hitwow/CPU-VHDL/CPU设计报告.docx

计算机设计与实践

CPU设计报告

班号：110103

学号：1110310305

姓名：王天博

## 1． 指令格式设计

指令伪码 | 指 令 | | | | 寻址方式
mov ri, n | 00000 | Ri | N | | 立即寻址
mov [addr], ri | 00001 | Ri | ADDR | | 直接寻址（寄存器->主存）
mov ri, [addr] | 00010 | Ri | ADDR | | 直接寻址（主存->寄存器）
mov ri, rj | 01000 | Ri | | Rj | 寄存器寻址
mov ri, [addr] | 00011 | Ri | ADDR | | 变址寻址
mov ri, @rj | 11000 | Ri | | Rj | 寄存器间址
adc ri, rj | 01001 | Ri | | Rj | 寄存器寻址
adc ri, n | 00100 | Ri | N | | 立即寻址
sbb ri, rj | 01010 | Ri | | Rj | 寄存器寻址
sbb ri, n | 00101 | Ri | N | | 立即寻址
and ri, rj | 01011 | Ri | | Rj | 寄存器寻址
and ri, n | 00110 | Ri | N | | 立即寻址
or ri, rj | 01100 | Ri | | Rj | 寄存器寻址
or ri, n | 00111 | Ri | N | | 立即寻址
stc | 10111 | | | | 无
clc | 11111 | | | | 无
jmp [addr] | 10000 | | ADDR | | 直接寻址
jz sign | 10001 | | SIGN | | 相对寻址
jc sign | 10010 | | SIGN | | 相对寻址

说明：

1. N为8位立即数
2. ADDR为地址低八位
3. Ri，Rj为寄存器编号，3位
4. SIGN为8位有符号数

## 2． 微操作的定义

微操作 | 含义
M(AD)->IR | 将存储器AD地址中的数据读到IR中
TD->M(TA) | 将TD中的数据写入存储器的TA地址中
1->RD | 将RD读信号置位
1->WR | 将WR写信号置位
1->RUD | 将RUD寄存器更新信号置位
1->PUD | 将PUD PC更新信号置位
0->Cy | 将Cy标志位清零
1->Cy | 将Cy标志位置位
OP(IR) | 取IR的15-11位的操作码
NM(IR) | 取IR的7-0位的操作数
Ad1(IR) | 取IR的10-8位的第一个寄存器编号
Ad2(IR) | 取IR的2-0位的第二个寄存器编号
Ad(IR) | 取IR的7-0位作为地址低八位
Reg(RN) | 编号为RN的寄存器
A+B+Cy | 寄存器A中的值与寄存器B中的值进行带进位加运算
A-B-Cy | 寄存器A中的值与寄存器B中的值进行带借位减运算
A and B | 寄存器A中的值与寄存器B中的值进行按位与运算
A or B | 寄存器A中的值与寄存器B中的值进行按位或运算
R7//Ad(IR) | R7作为地址的高八位，AD(IR)作为地址的低八位，拼接成16位物理地址
Z·Aluout->PDATA | 如果Z标志位为0，则将aluout的值送至PDATA
Cy·Aluout->PDATA | 如果Cy标志位为0，则将aluout的值送至PDATA

## 3． 节拍的划分

### 3.1. 非访存类指令

mov Ri, x

T0 M(PC)->IR, 1->RD, PC->PC+1

T1 OP(IR)->C, NM(IR)->RDATA

T2

T3 Ad1(IR)->RN, 1->RUD, RDATA->Reg(RN)

mov Rj, Ri

T0 M(PC)->IR, 1->RD, PC->PC+1

T1 OP(IR)->C, Reg(Ad2(IR))->RDATA

T2

T3 Ad1(IR)->RN, 1->RUD, RDATA->Reg(RN)

adc Ri, x

T0 M(PC)->IR, 1->RD, PC->PC+1

T1 OP(IR)->C, Reg(Ad1(IR))->A, NM(IR)->B, A+B+Cy->Aluout

T2

T3 Ad1(IR)->RN, Aluout->RDATA, 1->RUD, RDATA->Reg(RN)

adc Rj, Ri

T0 M(PC)->IR, 1->RD, PC->PC+1

T1 OP(IR)->C, Reg(Ad1(IR))->A, Reg(Ad2(IR))->B, A+B+Cy->Aluout

T2

T3 Ad1(IR)->RN, Aluout->RDATA, 1->RUD, RDATA->Reg(RN)

sbb Ri, x

T0 M(PC)->IR, 1->RD, PC->PC+1

T1 OP(IR)->C, Reg(Ad1(IR))->A, NM(IR)->B, A-B-Cy->Aluout

T2

T3 Ad1(IR)->RN, Aluout->RDATA, 1->RUD, RDATA->Reg(RN)

sbb Rj, Ri

T0 M(PC)->IR, 1->RD, PC->PC+1

T1 OP(IR)->C, Reg(Ad1(IR))->A, Reg(Ad2(IR))->B, A-B-Cy->Aluout

T2

T3 Ad1(IR)->RN, Aluout->RDATA, 1->RUD, RDATA->Reg(RN)

and Ri, x

T0 M(PC)->IR, 1->RD, PC->PC+1

T1 OP(IR)->C, Reg(Ad1(IR))->A, NM(IR)->B, A and B->Aluout

T2

T3 Ad1(IR)->RN, Aluout->RDATA, 1->RUD, RDATA->Reg(RN)

and Rj, Ri

T0 M(PC)->IR, 1->RD, PC->PC+1

T1 OP(IR)->C, Reg(Ad1(IR))->A, Reg(Ad2(IR))->B, A and B->Aluout

T2

T3 Ad1(IR)->RN, Aluout->RDATA, 1->RUD, RDATA->Reg(RN)

or Ri, x

T0 M(PC)->IR, 1->RD, PC->PC+1

T1 OP(IR)->C, Reg(Ad1(IR))->A, NM(IR)->B, A or B->Aluout

T2

T3 Ad1(IR)->RN, Aluout->RDATA, 1->RUD, RDATA->Reg(RN)

or Rj, Ri

T0 M(PC)->IR, 1->RD, PC->PC+1

T1 OP(IR)->C, Reg(Ad1(IR))->A, Reg(Ad2(IR))->B, A or B->Aluout

T2

T3 Ad1(IR)->RN, Aluout->RDATA, 1->RUD, RDATA->Reg(RN)

clc

T0 M(PC)->IR, 1->RD, PC->PC+1

T1 OP(IR)->C, 0->Cy

T2

T3

stc

T0 M(PC)->IR, 1->RD, PC->PC+1

T1 OP(IR)->C, 1->Cy

T2

T3

### 3.2. 访存类指令

mov addr, Ri

T0 M(PC)->IR, 1->RD, PC->PC+1

T1 OP(IR)->C, R7//Ad(IR)->TA, Reg(Ri)->TD

T2 TD->M(TA), 1->WR

T3

mov Ri, addr

T0 M(PC)->IR, 1->RD, PC->PC+1

T1 OP(IR)->C, R7//Ad(IR)->TA

T2 Aluout->TA, M(TA)->TD, 1->RD

T3 TD->RDATA, Ad1(IR)->RN, 1->RUD, RDATA->Reg(RN)

mov Ri, x (变址寻址，IX=R7）

T0 M(PC)->IR, 1->RD, PC->PC+1

T1 OP(IR)->C, R7+x->TA

T2 M(TA)->TD, 1->RD

T3 TD->RDATA, Ad1(IR)->RN, 1->RUD, RDATA->Reg(RN)

mov Ri, Rj (寄存器间址)

T0 M(PC)->IR, 1->RD, PC->PC+1

T1 OP(IR)->C, R7//Rj->TA

T2 M(TA)->TD, 1->RD

T3 TD->RDATA, Ad1(IR)->RN, 1->RUD, RDATA->Reg(RN)

### 3.3. 转跳指令

jmp addr

T0 M(PC)->IR, 1->RD, PC->PC+1

T1 OP(IR)->C, R7//Ad(IR)->PDATA

T2

T3 PDATA->PC, 1->PUD

jz sign

T0 M(PC)->IR, 1->RD, PC->PC+1

T1 OP(IR)->C, SN(IR)->A, A+PC->Aluout, Z·Aluout->PDATA

T2

T3 PDATA->PC, 1->PUD

jc sign

T0 M(PC)->IR, 1->RD, PC->PC+1

T1 OP(IR)->C, SN(IR)->A, A+PC->Aluout, Cy·Aluout->PDATA

T2

T3 PDATA->PC, 1->PUD

## 4． 处理器结构框图和功能描述

### 4.1. 整体设计框图

注：1. 图中连线名称为例化时相应的信号名

2. 由于图中空间有限，因而2根以上线的根数没有在图中标出，现单独列出如下：

连线名 | 连线根数
pc_o | 16
pc_i | 16
ir_i | 16
ir_o | 16
ad_o | 16
ad_i | 16
aluout | 8
r_n | 3
r_i | 8
r_o | 8
dt_i | 8
dt_o | 8
a_bus | 16
DBUS | 16

### 4.2. 处理器功能描述

处理器共分为六个模块。由机器周期的定义，将系统划分为四个主要模块：取指模块掌管取指周期，运算模块掌管运算周期，存储模块掌管访存周期，回写模块掌管回写周期。四个模块的工作流程由时钟模块统一调度。同时，在主存储器和各管理模块之间增加访存控制模块，来避免发生访问冲突以及保证空闲时总线不被占用。

在处理器开始工作时：

第一个节拍，取指模块将当前pc值发送给访存控制模块，由访存控制模块根据pc值读出存储器中的数据回传给取指模块，作为当前的ir指令，取指模块将ir指令发送给各模块；之后在第二个节拍的下降沿进行pc+1

第二个节拍，运算模块将传来的ir指令进行译码，根据操作码进行不同的运算。非访存类指令，运算的结果通过aluout输出给回写模块进行回写；访存类指令，将算出的地址通过ad_o输出给存储模块，若有要写入的数据则通过aluout输出到存储模块；转跳类指令，计算出新的pc值，然后将新的pc值通过ad_o输出给回写模块；

第三个节拍，如果有访存活动，则存储模块根据操作码的不同，或读或写，向访存控制模块发送读写信号，地址和数据，并将读出的数据通过Reg_o送到回写模块；

第四个节拍，如果有转跳指令，判断转跳的条件，若成立则发送pc更新信号和新的pc值给取指模块；若有回写寄存器的要求，则将回写的数值和回写的寄存器标号送到运算模块并发送回写信号。

## 5． 各功能模块结构框图和功能描述

### 5.1. 时钟模块

#### 5.1.1. 结构框图

clk

reset

c1

c2

c3

c4

时钟模块

#### 5.1.2. 信号定义

信号名 | 位数 | 方向 | 含义
clk | 1 | I | 时钟信号
reset | 1 | I | 复位信号
c1 | 1 | O | 节拍1
c2 | 1 | O | 节拍2
c3 | 1 | O | 节拍3
c4 | 1 | O | 节拍4

#### 5.1.3. 功能描述

向其他模块发送节拍信号，控制整个运行流程。

### 5.2. 取指模块

#### 5.2.1. 结构框图

c1

c2

reset

PC_O

IR_O

IR_R

PC_C

PC_I

取指模块

#### 5.2.2. 信号定义

信号名 | 位数 | 方向 | 含义
c1 | 1 | I | 节拍1，控制取值
c2 | 1 | I | 节拍2，控制PC+1
reset | 1 | I | 复位信号
IR_I | 16 | I | 访存控制模块传入的IR
PC_C | 1 | I | 回写模块传来的PC更新信号
PC_I | 16 | I | 回写模块传来的PC的更新值
PC_O | 16 | O | 向其他模块输出的PC值
IR_O | 16 | O | 向其他模块输出的IR值
IR_R | 1 | O | 向访存控制模块发送的读IR信号

#### 5.2.3. 功能描述

1. 向访存控制模块发送PC的内容，并接受访存控制模块传来的IR值；

2. 向各个模块发送IR的值

3. 若回写模块没有更新信号则将PC+1，若有则接收回写模块的信号更新PC

### 5.3. 运算模块

#### 5.3.1. 结构框图

c2

reset

IR_O

PC_O

Reg_C

Reg_I

Reg_N

AD_O

aluout

Z

Cy

运算模块

#### 5.3.2. 信号定义

信号名 | 位数 | 方向 | 含义
c2 | 1 | I | 节拍2，控制运算模块的执行
reset | 1 | I | 复位信号
IR_O | 16 | I | 取指模块传来的IR
PC_O | 16 | I | 取指模块传来的PC
Reg_C | 1 | I | 回写模块传来的寄存器更新信号
Reg_N | 3 | I | 回写模块传来的寄存器更新编号
Reg_I | 8 | I | 回写模块传来的寄存器更新数值
AD_O | 16 | O | 输出算出的地址
aluout | 8 | O | 输出算出的数据
Z | 1 | O | 零标志新号
Cy | 1 | O | 进位标志信号

#### 5.3.3. 功能描述

1. 根据IR操作码部分执行不同的运算

2. 接收回写模块传入的寄存器数据进行寄存器回写

### 5.4. 存储模块

#### 5.4.1. 结构框图

c3

reset

aluout

AD_O

IR_O

DT_O

Reg_O

AD_I

DT_I

WR_O

RD_O

存储模块

#### 5.4.2. 信号定义

信号名 | 位数 | 方向 | 含义
c3 | 1 | I | 节拍3，控制存储模块的执行
reset | 1 | I | 复位信号
IR_O | 16 | I | 取指模块传来的IR
AD_O | 16 | I | 运算模块传来的地址
aluout | 8 | I | 运算模块传来的数据
DT_I | 8 | I | 访存控制模块传来的数据
DT_O | 8 | O | 给访存控制模块送要写入的数据
RD_O | 1 | O | 给访存控制模块的读信号
WR_O | 1 | O | 给访存控制模块的写信号
Reg_O | 8 | O | 给回写模块送的数据
AD_I | 16 | O | 给访存控制模块送的地址

#### 5.4.3. 功能描述

1. 将要写入存储器的数据发送到访存控制模块，并向访存控制模块发送写入信号

2. 接收访存控制模块传来的数据送到回写模块

### 5.5. 回写模块

#### 5.5.1. 结构框图

reset

c4

aluout

AD_O

IR_O

Reg_O

Z

Cy

Reg_I

Reg_N

PC_I

Reg_C

PC_C

回写模块

#### 5.5.2. 信号定义

信号名 | 位数 | 方向 | 含义
c4 | 1 | I | 节拍4，控制回写模块的执行
reset | 1 | I | 复位信号
IR_O | 16 | I | 取指模块传来的IR
AD_O | 16 | I | 运算模块传来的地址
aluout | 8 | I | 运算模块传来的数据
Reg_O | 8 | I | 存储模块传来的数据
Z | 1 | I | 零标志信号
Cy | 1 | I | 进位标志信号
Reg_N | 3 | O | 寄存器更新编号
Reg_C | 1 | O | 寄存器更新信号
Reg_I | 8 | O | 寄存器更新数值
PC_C | 1 | O | PC更新信号
PC_I | 16 | O | PC更新数值

#### 5.5.3. 功能描述

1. 若转跳指令生效，则将转跳的地址写入PC；

2. 若有写入寄存器的操作，则发送寄存器回写信号，回写寄存器的值还有回写的寄存器编号

### 5.6. 访存控制模块

#### 5.5.1. 结构框图

RD_O

WR_O

PC_O

IR_R

AD_O

DT_O

DT_I

IR_I

nRD

nWR

ABUS

DBUS

nMREQ

nBLE

nBHE

访存控制模块

#### 5.5.2. 信号定义

信号名 | 位数 | 方向 | 含义
RD_O | 1 | I | 存储模块发来的读信号
WR_O | 1 | I | 存储模块发来的写信号
PC_O | 16 | I | 取指模块发来的PC值
IR_R | 1 | I | 取指模块发来的IR读信号
AD_O | 16 | I | 存储模块发来的地址
DT_O | 8 | I | 存储模块发来的写数据
DT_I | 8 | O | 向存储模块送出的读出数据
nRD | 1 | O | 存储器读控制
nWR | 1 | O | 存储器写控制
ABUS | 16 | O | 地址总线
DBUS | 16 | I/O | 数据总线
IR_I | 16 | O | 向取指模块发送的IR值
nBHE | 1 | O | 存储器高位字节允许访问
nBLE | 1 | O | 存储器低位字节允许访问
nMREQ | 1 | O | 存储器片选

#### 5.5.3. 功能描述

1. 向存储器中取指令或数据

2. 向存储器中写入数据

## 6． 实验代码和测试序列

### 6.1. VHDL代码

#### 时钟模块-clkblock.vhd

library IEEE;

use IEEE.STD_LOGIC_1164.ALL;

use IEEE.STD_LOGIC_ARITH.ALL;

use IEEE.STD_LOGIC_UNSIGNED.ALL;

entity clkblock is

port(clk : in std_logic;

reset : in std_logic;

c1 : out std_logic;

c2 : out std_logic;

c3 : out std_logic;

c4 : out std_logic);

end clkblock;

architecture Behavioral of clkblock is

signal t : std_logic_vector(3 downto 0);

begin

process (reset, clk)

begin

if reset = '1' then

t <= "0000";

else

if clk'event and clk='1' then

case t is

when "0000" => t <= "0001";

when "0001" => t <= "0010";

when "0010" => t <= "0100";

when "0100" => t <= "1000";

when "1000" => t <= "0001";

when others => t <= "0000";

end case;

end if;

end if;

end process;

c1 <= t(0);

c2 <= t(1);

c3 <= t(2);

c4 <= t(3);

end Behavioral;

#### 取指模块-ifblock.vhd

library IEEE;

use IEEE.STD_LOGIC_1164.ALL;

use IEEE.STD_LOGIC_ARITH.ALL;

use IEEE.STD_LOGIC_UNSIGNED.ALL;

entity ifblock is

Port ( c1 : in STD_LOGIC;

c2 : in STD_LOGIC;

PC_O : out STD_LOGIC_VECTOR (15 downto 0);

IR_I : in STD_LOGIC_VECTOR (15 downto 0);

IR_O : out STD_LOGIC_VECTOR (15 downto 0);

PC_C : in STD_LOGIC;

PC_I : in STD_LOGIC_VECTOR (15 downto 0);

IR_R : out STD_LOGIC;

reset : in STD_LOGIC);

end ifblock;

architecture Behavioral of ifblock is

signal PC_T : std_logic_vector (15 downto 0);

begin

process (reset, c1, c2, PC_C, IR_I)

begin

if reset='1' then

PC_T <= "0000000000000000";

IR_O <= "0000000000000000";

IR_R <= '0';

elsif c1='1' then

IR_R <= '1';

IR_O <= IR_I;

else

IR_R <= '0';

if c2='0' and c2'event then

PC_T <= PC_T+1;

end if;

if PC_C = '1' then

PC_T <= PC_I;

end if;

end if;

end process;

PC_O <= PC_T;

end Behavioral;

#### 运算模块-alublock.vhd

library IEEE;

use IEEE.STD_LOGIC_1164.ALL;

use IEEE.STD_LOGIC_ARITH.ALL;

use IEEE.STD_LOGIC_UNSIGNED.ALL;

entity alublock is

Port ( c2 : in STD_LOGIC;

reset : in STD_LOGIC;

IR_O : in STD_LOGIC_VECTOR (15 downto 0);

AD_O : out std_logic_vector (15 downto 0);

PC_O : in std_logic_vector (15 downto 0);

aluout : out STD_LOGIC_VECTOR (7 downto 0);

Reg_C : in STD_LOGIC;

Reg_N : in STD_LOGIC_VECTOR (2 downto 0);

Reg_I : in STD_LOGIC_VECTOR (7 downto 0);

Z : out std_logic;

Cy : out STD_LOGIC);

end alublock;

architecture Behavioral of alublock is

type reg IS array(0 to 7) of std_logic_vector(7 downto 0);

signal R : reg;

signal tc, tz : std_logic;

shared variable aluv : std_logic_vector (8 downto 0);

begin

process (ir_o, reset, c2, Reg_C)

variable ctr : std_logic_vector (4 downto 0);

variable r1, r2, x : std_logic_vector (8 downto 0);

begin

ctr := IR_O(15 downto 11);

r1 := '0'&R(conv_integer(IR_O(10 downto 8)));

r2 := '0'&R(conv_integer(IR_O(2 downto 0)));

x := '0'&IR_O(7 downto 0);

if reset='1' then

tz <= '0';

tc <= '0';

aluv := "000000000";

R(0) <= "00000000";

R(1) <= "00000000";

R(2) <= "00000000";

R(3) <= "00000000";

R(4) <= "00000000";

R(5) <= "00000000";

R(6) <= "00000000";

R(7) <= "00000000";

AD_O <= "0000000000000000";

elsif Reg_C = '1' then

R(conv_integer(IR_O(10 downto 8))) <= Reg_I;

elsif c2 = '1' and c2'event then

AD_O(15 downto 8) <= R(7);

case ctr is

when "11111" =>

tc <= '0';

when "10111" =>

tc <= '1';

when "00000" =>

aluv := x;

when "01000" =>

aluv := r2;

when "00100" =>

tz <= '0';

aluv := r1 + x + tc;

tc <= aluv(8);

if aluv(7 downto 0)="00000000" then

tz <= '1';

end if;

when "01001" =>

tz <= '0';

aluv := r1 + r2 + tc;

tc <= aluv(8);

if aluv(7 downto 0)="00000000" then

tz <= '1';

end if;

when "00101" =>

tz <= '0';

aluv := r1 - x - tc;

tc <= aluv(8);

if aluv(7 downto 0)="00000000" then

tz <= '1';

end if;

when "01010" =>

tz <= '0';

aluv := r1 - r2 - tc;

tc <= aluv(8);

if aluv(7 downto 0)="00000000" then

tz <= '1';

end if;

when "00110" =>

tz <= '0';

aluv := r1 and x;

if aluv(7 downto 0)="00000000" then

tz <= '1';

end if;

when "01011" =>

tz <= '0';

aluv := r1 and r2;

if aluv(7 downto 0)="00000000" then

tz <= '1';

end if;

when "00111" =>

tz <= '0';

aluv := r1 or x;

if aluv(7 downto 0)="00000000" then

tz <= '1';

end if;

when "01100" =>

tz <= '0';

aluv := r1 or r2;

if aluv(7 downto 0)="00000000" then

tz <= '1';

end if;

when "00001" =>

AD_O(15 downto 8) <= R(7);

AD_O(7 downto 0) <=x(7 downto 0);

aluv := r1;

when "00010" =>

AD_O(7 downto 0) <= x(7 downto 0);

when "00011" =>

AD_O(7 downto 0) <= (R(6)+x(7 downto 0));

when "10000" =>

AD_O(7 downto 0) <= x(7 downto 0);

when "11000" =>

AD_O(7 downto 0) <=r2(7 downto 0);

when "10001" =>

if tz = '1' then

if (IR_O(7) = '0') then

AD_O <= PC_O + ("00000000"&x(7 downto 0))+1;

else

AD_O <= PC_O - ("00000000"&x(7 downto 0))+1;

end if;

end if;

when "10010" =>

if tc = '1' then

if (IR_O(7) = '0') then

AD_O <= PC_O + ("00000000"&x(7 downto 0))+1;

else

AD_O <= PC_O - ("00000000"&x(7 downto 0))+1;

end if;

end if;

when others => NULL;

end case;

end if;

aluout <= aluv(7 downto 0);

end process;

Z <= tz;

Cy <= tc;

end Behavioral;

#### 存储模块-stblock.vhd

library IEEE;

use IEEE.STD_LOGIC_1164.ALL;

use IEEE.STD_LOGIC_ARITH.ALL;

use IEEE.STD_LOGIC_UNSIGNED.ALL;

entity stblock is

Port ( c3 : in STD_LOGIC;

reset : in STD_LOGIC;

IR_O : in STD_LOGIC_VECTOR (15 downto 0);

AD_O : in STD_LOGIC_VECTOR (15 downto 0);

aluout : in STD_LOGIC_VECTOR (7 downto 0);

DT_I : in STD_LOGIC_VECTOR (7 downto 0);

DT_O : out std_logic_vector (7 downto 0);

RD_O : out STD_LOGIC;

WR_O : out STD_LOGIC;

Reg_O : out STD_LOGIC_VECTOR (7 downto 0);

AD_I : out std_logic_vector (15 downto 0));

end stblock;

architecture Behavioral of stblock is

begin

process (ir_o, c3, reset, DT_I)

variable ctr : std_logic_vector (4 downto 0);

begin

ctr := IR_O(15 downto 11);

if reset = '1' then

DT_O <= "00000000";

RD_O <= '0';

WR_O <= '0';

Reg_O <= "00000000";

AD_I <= "0000000000000000";

elsif c3 = '1' then

case ctr is

when "00001" =>

DT_O <= aluout;

AD_I <= AD_O;

WR_O <= '1';

RD_O <= '0';

when "00010"|"00011"|"11000" =>

AD_I <= AD_O;

RD_O <= '1';

WR_O <= '0';

Reg_O <= DT_I;

when others => NULL;

end case;

else

RD_O <= '0';

WR_O <= '0';

end if;

end process;

end Behavioral;

#### 回写模块-rewblock.vhd

library IEEE;

use IEEE.STD_LOGIC_1164.ALL;

use IEEE.STD_LOGIC_ARITH.ALL;

use IEEE.STD_LOGIC_UNSIGNED.ALL;

entity rewblock is

Port ( c4 : in STD_LOGIC;

reset : in STD_LOGIC;

IR_O : in STD_LOGIC_VECTOR (15 downto 0);

aluout : in STD_LOGIC_VECTOR (7 downto 0);

Reg_O : in STD_LOGIC_VECTOR (7 downto 0);

AD_O : in STD_LOGIC_VECTOR (15 downto 0);

Z : in std_logic;

Cy : in std_logic;

Reg_N : out STD_LOGIC_VECTOR (2 downto 0);

Reg_C : out STD_LOGIC;

Reg_I : out STD_LOGIC_VECTOR (7 downto 0);

PC_C : out STD_LOGIC;

PC_I : out STD_LOGIC_VECTOR (15 downto 0));

end rewblock;

architecture Behavioral of rewblock is

begin

process(ir_o, c4, reset)

variable ctr : std_logic_vector (4 downto 0);

begin

if reset = '1' then

Reg_N <= "000";

Reg_C <= '0';

Reg_I <= "00000000";

PC_C <= '0';

PC_I <= "0000000000000000";

elsif c4 = '1' then

ctr := IR_O(15 downto 11);

case ctr is

when "00000"|"01000"|"00100"|"01001"|"01010"|"00110"|"01011"|"00111"|"01100"|"00101" =>

Reg_N <= IR_O(10 downto 8);

Reg_C <= '1';

Reg_I <= aluout;

when "00010"|"00011"|"11000" =>

Reg_N <= IR_O(10 downto 8);

Reg_C <= '1';

Reg_I <= Reg_O;

when "10000" =>

PC_C <= '1';

PC_I <= AD_O;

when "10001" =>

if Z = '1' then

PC_C <= '1';

PC_I <= AD_O;

end if;

when "10010" =>

if Cy = '1' then

PC_C <= '1';

PC_I <= AD_O;

end if;

when others => NULL;

end case;

else

PC_C <= '0';

Reg_C <= '0';

end if;

end process;

end Behavioral;

#### 访存控制模块-stctrblock.vhd

library IEEE;

use IEEE.STD_LOGIC_1164.ALL;

use IEEE.STD_LOGIC_ARITH.ALL;

use IEEE.STD_LOGIC_UNSIGNED.ALL;

entity stctrblock is

Port ( RD_O : in STD_LOGIC;

WR_O : in STD_LOGIC;

PC_O : in STD_LOGIC_VECTOR (15 downto 0);

IR_R : in std_logic;

AD_O : in STD_LOGIC_VECTOR (15 downto 0);

DT_O : in STD_LOGIC_VECTOR (7 downto 0);

DT_I : out STD_LOGIC_VECTOR (7 downto 0);

nRD : out STD_LOGIC;

nWR : out STD_LOGIC;

ABUS : out STD_LOGIC_VECTOR (15 downto 0);

DBUS : inout STD_LOGIC_VECTOR (15 downto 0);

IR_I : out STD_LOGIC_VECTOR (15 downto 0);

nBHE : out STD_LOGIC;

nBLE : out STD_LOGIC;

nMERQ : out STD_LOGIC);

end stctrblock;

architecture Behavioral of stctrblock is

begin

process (RD_O, WR_O, IR_R)

begin

if (IR_R = '1') then

nRD <= '0';

nWR <= '1';

nBHE <= '0';

nBLE <= '0';

nMERQ <= '0';

ABUS <= PC_O;

IR_I <= DBUS;

DBUS <= "ZZZZZZZZZZZZZZZZ";

elsif (RD_O = '1') then

nRD <= '0';

nWR <= '1';

nBHE <= '0';

nBLE <= '0';

nMERQ <= '0';

ABUS <= AD_O;

DT_I <= DBUS(7 downto 0);

DBUS <= "ZZZZZZZZZZZZZZZZ";

elsif (WR_O = '1') then

nRD <= '1';

nWR <= '0';

nBHE <= '0';

nBLE <= '0';

nMERQ <= '0';

ABUS <= AD_O;

DBUS <= "00000000"&DT_O;

else

nRD <= '1';

nWR <= '1';

nBHE <= '1';

nBLE <= '1';

nMERQ <= '1';

ABUS <= "0000000000000000";

IR_I <= "0000000000000000";

DBUS <= "ZZZZZZZZZZZZZZZZ";

DT_I <= "00000000";

end if;

end process;

end Behavioral;

#### 例化文件-cpuall.vhd

library IEEE;

use IEEE.STD_LOGIC_1164.ALL;

use IEEE.STD_LOGIC_ARITH.ALL;

use IEEE.STD_LOGIC_UNSIGNED.ALL;

entity cpuall is

port(clk: in std_logic;

reset: in std_logic;

Dbus: inout std_logic_vector(15 downto 0);

Abus: out std_logic_vector(15 downto 0);

nMREQ: out std_logic;

nWR: out std_logic;

nRD: out std_logic;

nBLE,nBHE: out std_logic;

Sd : out std_logic_vector(15 downto 0);

Sa : out std_logic_vector(15 downto 0);

Sp : out std_logic_vector(15 downto 0);

Ct : out std_logic_vector(7 downto 0);

CL : out std_logic_vector(3 downto 0));

end cpuall;

architecture Behavioral of cpuall is

component clkblock is

port(clk : in std_logic;

reset : in std_logic;

c1 : out std_logic;

c2 : out std_logic;

c3 : out std_logic;

c4 : out std_logic);

end component;

component ifblock is

Port ( c1 : in STD_LOGIC;

c2 : in STD_LOGIC;

PC_O : out STD_LOGIC_VECTOR (15 downto 0);

IR_I : in STD_LOGIC_VECTOR (15 downto 0);

IR_O : out STD_LOGIC_VECTOR (15 downto 0);

PC_C : in STD_LOGIC;

PC_I : in STD_LOGIC_VECTOR (15 downto 0);

IR_R : out STD_LOGIC;

reset : in STD_LOGIC);

end component;

component alublock is

Port ( c2 : in STD_LOGIC;

reset : in STD_LOGIC;

IR_O : in STD_LOGIC_VECTOR (15 downto 0);

AD_O : out std_logic_vector (15 downto 0);

PC_O : in std_logic_vector (15 downto 0);

aluout : out STD_LOGIC_VECTOR (7 downto 0);

Reg_C : in STD_LOGIC;

Reg_N : in STD_LOGIC_VECTOR (2 downto 0);

Reg_I : in STD_LOGIC_VECTOR (7 downto 0);

Z : out std_logic;

Cy : out STD_LOGIC);

end component;

component stblock is

Port ( c3 : in STD_LOGIC;

reset : in STD_LOGIC;

IR_O : in STD_LOGIC_VECTOR (15 downto 0);

AD_O : in STD_LOGIC_VECTOR (15 downto 0);

aluout : in STD_LOGIC_VECTOR (7 downto 0);

DT_I : in STD_LOGIC_VECTOR (7 downto 0);

DT_O : out std_logic_vector (7 downto 0);

RD_O : out STD_LOGIC;

WR_O : out STD_LOGIC;

Reg_O : out STD_LOGIC_VECTOR (7 downto 0);

AD_I : out std_logic_vector (15 downto 0));

end component;

component rewblock is

Port ( c4 : in STD_LOGIC;

reset : in STD_LOGIC;

IR_O : in STD_LOGIC_VECTOR (15 downto 0);

aluout : in STD_LOGIC_VECTOR (7 downto 0);

Reg_O : in STD_LOGIC_VECTOR (7 downto 0);

AD_O : in STD_LOGIC_VECTOR (15 downto 0);

Z : in std_logic;

Cy : in std_logic;

Reg_N : out STD_LOGIC_VECTOR (2 downto 0);

Reg_C : out STD_LOGIC;

Reg_I : out STD_LOGIC_VECTOR (7 downto 0);

PC_C : out STD_LOGIC;

PC_I : out STD_LOGIC_VECTOR (15 downto 0));

end component;

component stctrblock is

Port ( RD_O : in STD_LOGIC;

WR_O : in STD_LOGIC;

PC_O : in STD_LOGIC_VECTOR (15 downto 0);

IR_R : in std_logic;

AD_O : in STD_LOGIC_VECTOR (15 downto 0);

DT_O : in STD_LOGIC_VECTOR (7 downto 0);

DT_I : out STD_LOGIC_VECTOR (7 downto 0);

nRD : out STD_LOGIC;

nWR : out STD_LOGIC;

ABUS : out STD_LOGIC_VECTOR (15 downto 0);

DBUS : inout STD_LOGIC_VECTOR (15 downto 0);

IR_I : out STD_LOGIC_VECTOR (15 downto 0);

nBHE : out STD_LOGIC;

nBLE : out STD_LOGIC;

nMERQ : out STD_LOGIC);

end component;

signal c1, c2, c3, c4 : std_logic;

signal n_BLE, n_BHE, n_MREQ, n_RD, n_WR : std_logic;

signal pc_i, pc_o : std_logic_vector(15 downto 0);

signal ir_i, ir_o : std_logic_vector(15 downto 0);

signal pc_c, r_c : std_logic;

signal ir_r : std_logic;

signal z, c : std_logic;

signal ad_o, ad_i : std_logic_vector(15 downto 0);

signal aluout : std_logic_vector(7 downto 0);

signal r_n : std_logic_vector(2 downto 0);

signal r_i, r_o : std_logic_vector(7 downto 0);

signal dt_i, dt_o : std_logic_vector(7 downto 0);

signal rd_o, wr_o : std_logic;

signal a_bus : std_logic_vector(15 downto 0);

begin

U0 : clkblock port map (clk, reset, c1, c2, c3, c4);

U1 : ifblock port map (c1, c2, pc_o, ir_i, ir_o, pc_c, pc_i, ir_r, reset);

U2 : alublock port map (c2, reset, ir_o, ad_o, pc_o, aluout, r_c, r_n, r_i, z, c);

U3 : stblock port map (c3, reset, ir_o, ad_o, aluout, dt_i, dt_o, rd_o, wr_o, r_o, ad_i);

U4 : rewblock port map (c4, reset, ir_o, aluout, r_o, ad_o, z, c, r_n, r_c, r_i, pc_c, pc_i);

U5 : stctrblock port map (rd_o, wr_o, pc_o, ir_r, ad_o, dt_o, dt_i, n_RD, n_WR, a_bus, Dbus, ir_i, n_BHE, n_BLE, n_MREQ);

Abus <= a_bus;

nBHE <= n_BHE;

nBLE <= n_BLE;

nMREQ <= n_MREQ;

nRD <= n_RD;

nWR <= n_WR;

Sd <= Dbus;

Sa <= a_bus;

Sp <= ir_o;

Ct(7) <= not n_BHE;

Ct(6) <= not n_BLE;

Ct(5) <= not n_MREQ;

Ct(4) <= rd_o;

Ct(3) <= wr_o;

Ct(2) <= r_c;

Ct(1) <= z;

Ct(0) <= c;

CL(3) <= c4;

CL(2) <= c3;

CL(1) <= c2;

CL(0) <= c1;

end Behavioral;

### 6.2. UCF文件

#PACE: Start of Constraints generated by PACE

#PACE: Start of PACE I/O Pin Assignments

NET "Abus<0>" LOC = "P179" ;

NET "Abus<10>" LOC = "P115" ;

NET "Abus<11>" LOC = "P116" ;

NET "Abus<12>" LOC = "P119" ;

NET "Abus<13>" LOC = "P140" ;

NET "Abus<14>" LOC = "P144" ;

NET "Abus<15>" LOC = "P145" ;

NET "Abus<1>" LOC = "P178" ;

NET "Abus<2>" LOC = "P177" ;

NET "Abus<3>" LOC = "P172" ;

NET "Abus<4>" LOC = "P171" ;

NET "Abus<5>" LOC = "P151" ;

NET "Abus<6>" LOC = "P150" ;

NET "Abus<7>" LOC = "P147" ;

NET "Abus<8>" LOC = "P146" ;

NET "Abus<9>" LOC = "P113" ;

NET "CL<0>" LOC = "P102" ;

NET "CL<1>" LOC = "P100" ;

NET "CL<2>" LOC = "P99" ;

NET "CL<3>" LOC = "P98" ;

NET "clk" LOC = "P75" ;

NET "Ct<0>" LOC = "P196" ;

NET "Ct<1>" LOC = "P193" ;

NET "Ct<2>" LOC = "P192" ;

NET "Ct<3>" LOC = "P190" ;

NET "Ct<4>" LOC = "P3" ;

NET "Ct<5>" LOC = "P200" ;

NET "Ct<6>" LOC = "P199" ;

NET "Ct<7>" LOC = "P197" ;

NET "Dbus<0>" LOC = "P167" ;

NET "Dbus<10>" LOC = "P123" ;

NET "Dbus<11>" LOC = "P128" ;

NET "Dbus<12>" LOC = "P132" ;

NET "Dbus<13>" LOC = "P133" ;

NET "Dbus<14>" LOC = "P134" ;

NET "Dbus<15>" LOC = "P135" ;

NET "Dbus<1>" LOC = "P165" ;

NET "Dbus<2>" LOC = "P164" ;

NET "Dbus<3>" LOC = "P163" ;

NET "Dbus<4>" LOC = "P162" ;

NET "Dbus<5>" LOC = "P161" ;

NET "Dbus<6>" LOC = "P160" ;

NET "Dbus<7>" LOC = "P153" ;

NET "Dbus<8>" LOC = "P120" ;

NET "Dbus<9>" LOC = "P122" ;

NET "nBHE" LOC = "P138" ;

NET "nBLE" LOC = "P137" ;

NET "nMREQ" LOC = "P168" ;

NET "nRD" LOC = "P139" ;

NET "nWR" LOC = "P152" ;

NET "reset" LOC = "P154" ;

NET "Sa<0>" LOC = "P31" ;

NET "Sa<10>" LOC = "P47" ;

NET "Sa<11>" LOC = "P48" ;

NET "Sa<12>" LOC = "P49" ;

NET "Sa<13>" LOC = "P50" ;

NET "Sa<14>" LOC = "P55" ;

NET "Sa<15>" LOC = "P56" ;

NET "Sa<1>" LOC = "P33" ;

NET "Sa<2>" LOC = "P34" ;

NET "Sa<3>" LOC = "P35" ;

NET "Sa<4>" LOC = "P36" ;

NET "Sa<5>" LOC = "P39" ;

NET "Sa<6>" LOC = "P40" ;

NET "Sa<7>" LOC = "P41" ;

NET "Sa<8>" LOC = "P42" ;

NET "Sa<9>" LOC = "P45" ;

NET "Sd<0>" LOC = "P4" ;

NET "Sd<10>" LOC = "P22" ;

NET "Sd<11>" LOC = "P23" ;

NET "Sd<12>" LOC = "P24" ;

NET "Sd<13>" LOC = "P25" ;

NET "Sd<14>" LOC = "P28" ;

NET "Sd<15>" LOC = "P29" ;

NET "Sd<1>" LOC = "P5" ;

NET "Sd<2>" LOC = "P8" ;

NET "Sd<3>" LOC = "P9" ;

NET "Sd<4>" LOC = "P11" ;

NET "Sd<5>" LOC = "P12" ;

NET "Sd<6>" LOC = "P15" ;

NET "Sd<7>" LOC = "P16" ;

NET "Sd<8>" LOC = "P18" ;

NET "Sd<9>" LOC = "P19" ;

NET "Sp<0>" LOC = "P60" ;

NET "Sp<10>" LOC = "P129" ;

NET "Sp<11>" LOC = "P202" ;

NET "Sp<12>" LOC = "P203" ;

NET "Sp<13>" LOC = "P205" ;

NET "Sp<14>" LOC = "P206" ;

NET "Sp<15>" LOC = "P103" ;

NET "Sp<1>" LOC = "P61" ;

NET "Sp<2>" LOC = "P62" ;

NET "Sp<3>" LOC = "P63" ;

NET "Sp<4>" LOC = "P2" ;

NET "Sp<5>" LOC = "P108" ;

NET "Sp<6>" LOC = "P109" ;

NET "Sp<7>" LOC = "P112" ;

NET "Sp<8>" LOC = "P126" ;

NET "Sp<9>" LOC = "P127" ;

#PACE: Start of PACE Area Constraints

#PACE: Start of PACE Prohibit Constraints

#PACE: End of Constraints generated by PACE

### 6.3. 测试指令序列

表1：测试指令含义

指令 | 含义 | 寻址方式
mov r0, 01 | 将01赋给寄存器R0 | 立即寻址
mov r1, 02 | 将02赋给寄存器R1 | 立即寻址
mov r7, 03 | 将03赋给寄存器R7 | 立即寻址
mov [02], r0 | 将R0的值写入主存地址[R7//02] | 直接寻址
mov r2, [02] | 将主存地址[R7//02]的值写入R2 | 直接寻址
mov R6, R1 | 将R1的值写入R6 | 寄存器寻址
mov R4, 05 | 将主存地址[R7//(R6+05)]的值写入R4 | 变址寻址
mov R5，R2 | 将主存地址[R7//R2]的值写入R5 | 寄存器间址
adc R0, R1 | 将R0和R1中的值相加结果回写回R0 | 寄存器寻址
adc R0, FD | 将R0中的值和FD相加结果回写回R0 | 立即寻址
sbb R1, 01 | 将R1中的值减去01，结果回写回R1 | 立即寻址
jz 05 | 若Z标志位为1，则转跳到PC+5+1 | 相对寻址
sbb R4, R2 | 将R4中的值减去R2，结果回写回R4 | 寄存器寻址
STC | 将Cy标志位置为1
jc 08 | 若Cy标志位为1，则转跳到pc+8+1 | 相对寻址
CLC | 将Cy标志位置为0
and R4, 07 | 将R4中的值和07进行and运算，结果回写回R4 | 立即寻址
and R4, R2 | 将R4和R2进行and运算，结果回写回R4 | 寄存器寻址
or R4, 02 | 将R4中的值和02进行or运算，结果回写回R4 | 立即寻址
or R4, r2 | 将R4和R2进行or运算，结果回写回R4 | 寄存器寻址
mov [10],r4 | 将R4中的值写入主存地址[R7//10] | 直接寻址
jmp [09] | 转跳到地址[R7//09] | 直接寻址
jz 05 | 若Z标志位为1，则转跳到PC+5+1 | 相对寻址
jc 08 | 若Cy标志位为1，则转跳到pc+8+1 | 相对寻址
mov r7, 00 | 将00赋给寄存器R7 | 立即寻址
jmp [00] | 转跳到地址[R7//00]，即地址0000h，为程序的开始地址 | 直接寻址

表2：测试指令的运行结果

地址 | 指令 | 二进制 | 16进制 | 结果
0000 | mov r0, 01 | 00000 000 00000001 | 0001 | R0=01
0001 | mov r1, 02 | 00000 001 00000010 | 0102 | R1=02
0002 | mov r7, 03 | 00000 111 00000011 | 0703 | R7=03
0003 | mov [02], r0 | 00001 000 00000010 | 0802 | [02]=01
0004 | mov r2, [02] | 00010 010 00000010 | 1202 | R2=[02]=01
0005 | mov R6, R1 | 01000 110 00000001 | 4601 | R6=02
0006 | mov R4, 05 | 00011 100 00000101 | 1C05 | R4=[R7//(R6+05)]
0007 | mov R5, R2 | 11000 101 00000010 | C502 | R5=[R7//R2]
0008 | adc R0, R1 | 01001 000 00000001 | 4801 | R0=03
0009 | adc R0, FD | 00100 000 11111101 | 20FD | R0=00, CY=1，Z=1
000a | sbb R1, 01 | 00101 001 00000001 | 2901 | R1=00, Z=1
000b | jz 05 | 10001 000 00000101 | 8805 | PC=PC+5+1
0011 | sbb R4, R2 | 01010 100 00000010 | 5402 | R4=05
0012 | STC | 10111 000 00000000 | B800 | CY=1
0013 | jc 08 | 10010 000 00001000 | 9008 | PC=PC+8+1
001c | CLC | 11111 000 00000000 | F800 | CY=0
001d | and R4, 07 | 00110 100 00000111 | 3407 | R4=05
001e | and R4, R2 | 01011 100 00000010 | 5C02 | R4=01
001f | or R4, 02 | 00111 100 00000010 | 3c02 | R4=03
0020 | or R4, r2 | 01100 100 00000010 | 6402 | R4=03
0021 | mov [10],r4 | 00001 100 00010000 | 0c10 | [10]=03
0022 | jmp [09] | 10000 000 00001001 | 8009 | PC=R7//09
0309 | jz 05 | 10001 000 00000101 | 8805
030a | jc 08 | 10010 000 00001000 | 9008
030b | mov r7, 00 | 00000 111 00000000 | 0700 | R7=00
030c | jmp [00] | 10000 000 00000000 | 8000 | pc=0000

## 7． 总结与问题

### 7.1. 实验总结

这次实验一共用了四周时间。在这四周时间里，我学到的东西，可能比过去一个学期里面学习到的东西都多。第一次从头到尾设计一个大的vhdl工程，第一次编写这么多vhdl代码，第一次认识到硬件程序的设计是多么的复杂。从开始的整体结构的设计，节拍的划分，到各个模块的细节设计，各个模块的仿真，到最后整体的仿真和下载，我熟悉了一个工程的建立过程，熟悉了vhdl的各种知识，对硬件也有了更深刻的了解。我意识到，我原来vhdl的知识还很薄弱，比如最简单但是最重要的时序控制，对变量和信号的使用，许多原来没用过的函数，也遇到了许多原来没遇到的问题。经过了这次实验，现在我对vhdl语言的编程以及控制更加的熟悉了，也对整个设计流程有了深入的了解。

### 7.2. 遇到的问题

1. 设计过程

(1). 开始的时候，由于对老师的要求理解有错误，指令格式设计的有问题，并且不得不采用单双混长的格式设计指令；后来经过与老师的交流明白了实验的要求，采用了简单易行的单字节指令。

(2). Pc+1的时间问题。由于直接在第一个节拍进行pc+1会造成错误，因此在请教了老师之后，将pc+1放在第二个节拍的下降沿进行，保证取值时候pc的正确。代码如下：

if c2='0' and c2'event then

PC_T <= PC_T+1;

end if;

(3). 寄存器类型定义的问题。开始的时候不知道寄存器该怎么定义，通过查资料知道了可以采用如下方式进行定义：

type reg IS array(0 to 7) of std_logic_vector(7 downto 0);

signal R : reg;

首先定义一个reg类型，该类型为一个8*8的二维数组，然后利用这个数组声明一个寄存器组R，实现了通用寄存器的定义。

(4). 寄存器访问的问题。定义了寄存器之后，不知道该怎么对指定的寄存器进行操作，后来通过请教同学知道了可以采用如下方法：

R(conv_integer(IR_O(10 downto 8))

利用conv_integer()函数将二进制数转化为整形数。

2. 仿真过程

(1). 仿真过程出现的最大的问题就是运算模块的时序问题。由于开始设计的时候对vhdl语言并行语句和顺序语句的性质不是很熟悉，而且对信号的赋值时机的知识没有掌握好，导致运算模块出现了各种各样的问题，如输出结果延后一周期，Cy不能正确赋值等。后来通过对这些知识的熟悉，调整了语句的顺序，并且对赋值后立即就要用的量，比如操作码，采取变量方式进行存储，解决了运算模块出现的各种各样的问题，通过了仿真；

(2). 仿真过程中的第二个问题出现在访存控制模块。由于对inout类型的信号怎么使用不是很熟悉，导致在向inout信号写入的时候仿真出现错误。后来在老师的指导下，通过设置高阻的方式，成功通过了仿真。

3. 下载过程

(1). 下载过程遇到的第一个问题，是写入寄存器的时候，每次总是写入固定的一个寄存器，经过分析，觉得是实验台的问题。更换了实验台，问题得到了解决。

(2). 下载过程中遇到的最大的问题，是Cy和Z的两个标志位的问题。由于硬件实验台和软件仿真的区别，很多在仿真的时候没有暴漏出来的问题在下载的时候暴露了出来。首先是stc和clc这两条指令，在仿真的时候，没有看出来当时赋值的是alu（8）而不是tc，导致stc和clc这两条指令无效，后来经过检查代码改了过来；后来做带进位加法的时候发现本周期产生的进位会加到本周期的计算结果中，于是继续对时序进行更改，解决了这个问题；后来又发现，Z在置位之后无法变为0，检查代码发现，每次运算的时候只是对Z需要置位的情况进行了处理而没有对Z置为零的情况进行处理，于是加上了Z要置为0的情况。
