hitwow/CPU-VHDL/(list of files, cad)

Other CAD files:
lab7/isim/work/alublock/mingw/behavioral.obj
lab7/isim/work/clkblock/mingw/behavioral.obj
lab7/isim/work/glbl/mingw/glbl.obj
lab7/isim/work/ifblock/mingw/behavioral.obj
lab7/isim/work/rewblock/mingw/behavioral.obj
lab7/isim/work/stblock/mingw/behavioral.obj
lab7/isim/work/w__alublock/mingw/w__alublock.obj
lab7/isim/work/w__clkblock/mingw/w__clkblock.obj
lab7/isim/work/w__rewblock/mingw/w__rewblock.obj
lab7/isim/work/w_alublock/mingw/testbench_arch.obj
lab7/isim/work/w_clkblock/mingw/testbench_arch.obj
lab7/isim/work/w_clockblock/mingw/testbench_arch.obj
lab7/isim/work/w_ifblock/mingw/testbench_arch.obj
lab7/work/alublock/behavioral.psm
lab7/work/clkblock/behavioral.psm
lab7/work/cpuall/behavioral.psm
lab7/work/ifblock/behavioral.psm
lab7/work/rewblock/behavioral.psm
lab7/work/stblock/behavioral.psm
lab7/work/stctrblock/behavioral.psm
lab7/work/w_cpuall/testbench_arch.psm
